acrobotic/Ai_Pulsar_Hardware/pcb/fab/BOM.xls

Ai Pulsar – BOM
Cisco Zabala (x1sc0@acrobotic.com) last updated: 31.07.2015
Manufacturer | Manuf. Part Number | Vendor | Vendor Part Number | SKU | Type | Designator | Qty | Description | Case | SMD, BGA, LCC, OR TH | Notes
Vishay | CRCW060322R0JNEA | Digi-Key | 541-22GTR-ND | RES-00003-022 | Resistors | R1, R2 | 2 | RES 22 OHM 1/10W 5% 0603 | 0603 | SMD
Vishay | CRCW060310K0JNEA | Digi-Key | 541-10KGTR-ND | RES-00003-103 |  | R3, R4 | 2 | RES 10K OHM 1/10W 5% 0603 | 0603 | SMD
Vishay | CRCW0603100RJNEA | Digi-Key | 541-100GTR-ND | RES-00003-110 |  | R5 | 1 | RES 100 OHM 1/10W 5% 0603 | 0603 | SMD
Vishay | CRCW06031K00JNEA | Digi-Key | 541-1.0KGTR-ND | RES-00003-102 |  | R6, R7 | 2 | RES 1K OHM 1/10W 5% 0603 | 0603 | SMD
Vishay | CRCW0603330RJNEA | Digi-Key | 541-330GTR-ND | RES-00003-133 |  | R8, R9 | 2 | RES 330 OHM 1/10W 5% 0603 | 0603 | SMD
Bel Fuse | 0ZCJ0075FF2E | Digi-Key | 507-1804-1-ND | PWR-00013 |  | F1 | 1 | PTC RESTTBLE 0.75A 6V CHIP 1206 | 0603 | SMD
Murata | GRM188R61A106ME69D | Digi-Key | 490-10475-2-ND | CAP-00004-310 | Capacitors | C1, C3 | 2 | CAP CER 10UF 10V 0603 | 0603 | SMD
Samsung | CL10F104ZA8NNNC | Digi-Key | 1276-1011-2-ND | CAP-00004-610 |  | C2, C4, C5, C6…C29 | 27 | CAP CER 0.1UF 25V 0603 | 0603 | SMD
Epson | MC-146 32.768KA-AC3:ROHS | Mouser | 732-MC14632.76KAAC3R | FRQ-00005 | Crystals | XL1 | 1 | CRYSTAL 32.768KHZ 12.5PF SMD (MC-146) | 5mm x 1.5mm | SMD
NXP | PMEG4005CT,215 | Mouser | 771-PMEG4005CT215 | DIO-00008 | Diode | D1 | 1 | SCHOTTKY DIODE 31ACDBZR/SOT (PMEG4005CT) | SOT-23 | SMD
WorldSemi | WS2812B | WorldSemi | WS2812B | LED-00008 | LEDs | LED1…LED24 | 24 | WS8212B RGB LED | 5050 | SMD | ONLY INSTALL IN 35 BOARDS
OSRAM | LY L29K-H1K2-26-Z | Digi-Key | 475-1196-1-ND | LED-00036 |  | LED25, LED26 | 2 | LED YELLOW 587NM 0603 SMD | 0603 | SMD
RF Digital | RFD-22301 | Acrobotic | RFD-22301 | RFD-22301 | ICs | RFDUINO | 1 | RFduino BLE 4.0 SMT Module | - | SMD | DNI
Maxim | DS1307Z+T&R | Digi-Key | DS1307Z+T&RCT-ND | CHP-00037 |  | IC1 | 1 | IC RTC CLK/CALENDAR I2C 8-SOIC (DS1307) | 8-SOIC | SMD
Micrel | MIC5219-3.3YM5 TR | Digi-Key | 576-1281-1-ND | CHP-00027 |  | U1 | 1 | IC REG LDO 3.3V 0.5A SOT23-5 (MIC5219-3.3) | SOT23-5 | SMD
FTDI | FT231XQ-R | Mouser | 895-FT231XQ-R | CHP-00046 |  | U2 | 1 | USB Interface IC USB to Full Serial UART IC QFN-20 (FT231X) |  | SMD
Keystone | 3030TR | Mouser | 534-3030TR | CON-00037 | Connectors | 3V-BATT | 1 | 10MM SM COIN BATTERY HOLDER SMD | - | SMD
JST | S3B-PH-SM4-TB(LF)(SN) | Digi-Key | 455-1750-2-ND | CON-00039 |  | J1 | 1 | JST 3-PIN CCONNECTOR MALE (SMT) | JST-3P-SMD | SMD
JST |  | Digi-Key |  | CON-00038 |  | J2 | 1 | JST 2-PIN CCONNECTOR MALE (SMT) | JST-2P-SMD | SMD | DNI
 |  | Acrobotic | CON-00014 | CON-00014 | Connect. | USB1 | 1 | USB Micro-B Connector (Through Hole) | - | TH | Similar to: http://j.mp/1IuNWtk
