acrobotic/Ai_Pulsar_Hardware/pcb/ai_pulsar.brd

## EAGLE design pcb/ai_pulsar.brd (2016-04-01)

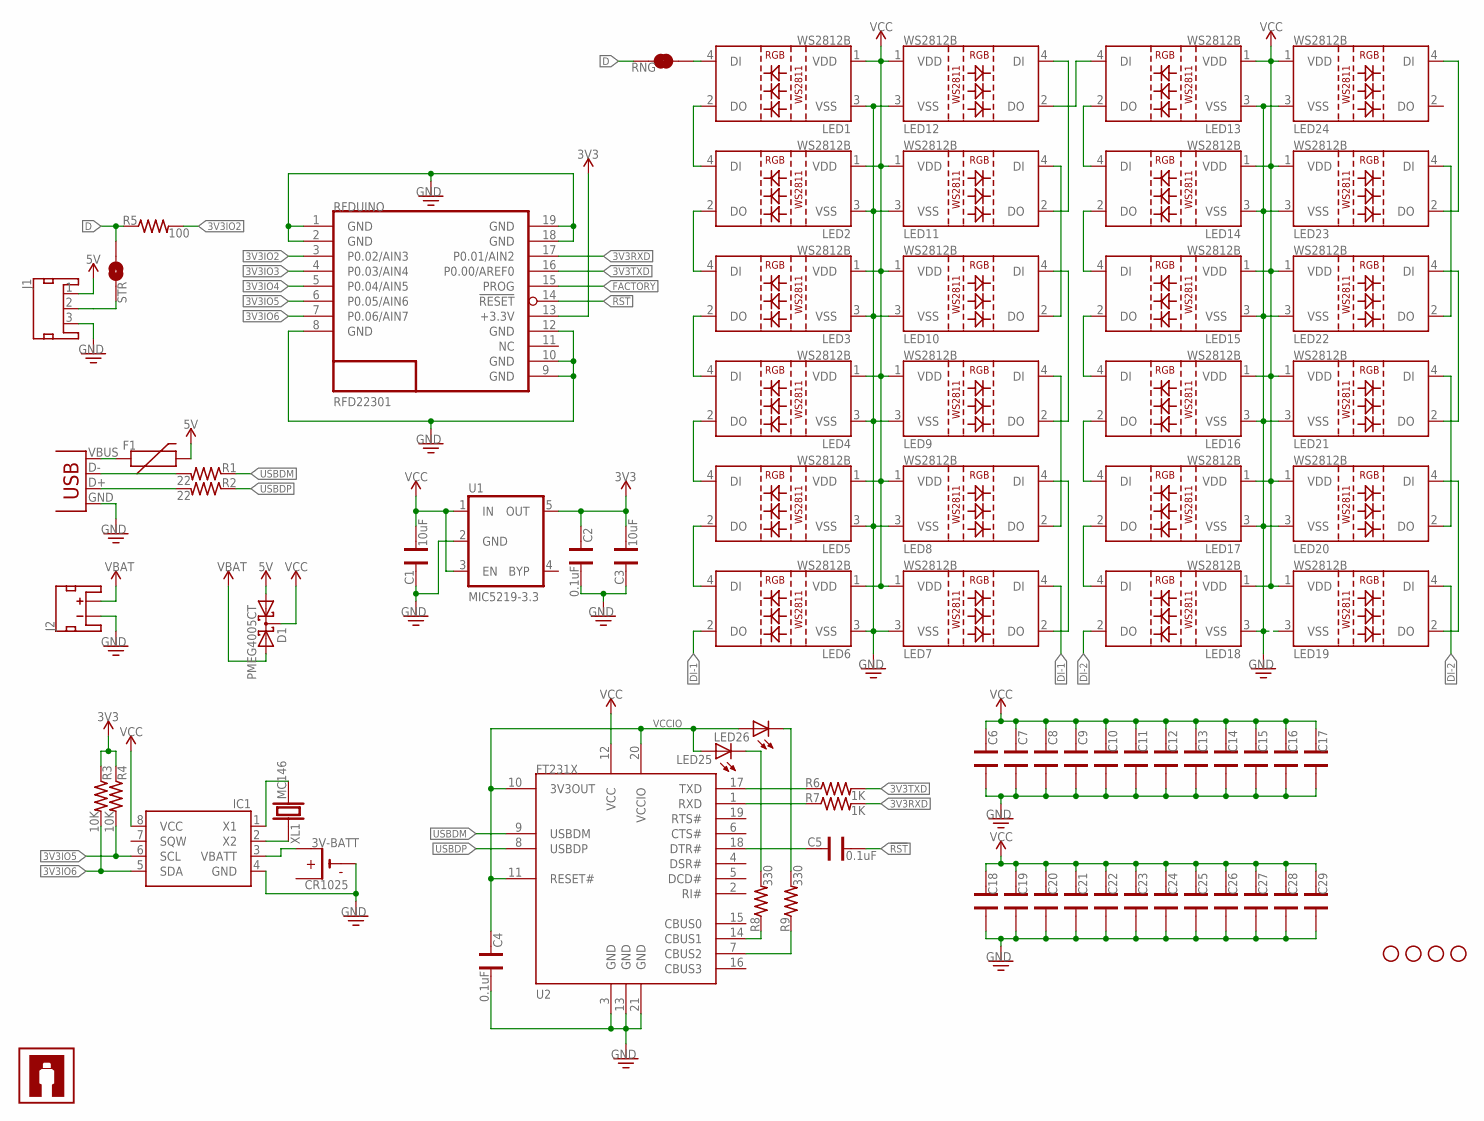
[picture p1: schematic ai_pulsar.sch]

Parts:
3V-BATT: CR1025; CR1025-SMD
C1, C3: 10uF; CAP-0603
C2, C4, C5: 0.1uF; CAP-0603
C6, C7, C8, C9, C10, C11, C12, C13, C14, C15, C16, C17, C18, C19, C20, C21, C22, C23, C24, C25, C26, C27, C28, C29: CAP0603; CAP-0603
D1: PMEG4005CT; SOT-23
F1: PTCSMD; PTC-1206
IC1: DS1307SO8-TIGHT; SO08-TIGHT
J1: JST-3P-MALE; JST-3P-SMD
J2: JST-2P-MALE; JST-2P-SMD
LED1, LED2, LED3, LED4, LED5, LED6, LED7, LED8, LED9, LED10, LED11, LED12, LED13, LED14, LED15, LED16, LED17, LED18, LED19, LED20, LED21, LED22, LED23, LED24: LED-WS2812B-SM
LED25, LED26: LED0603; LED-0603
R1, R2: 22; RES-0603
R3, R4: 10K; RES-0603
R5: 100; RES-0603
R6, R7: 1K; RES-0603
R8, R9: 330; RES-0603
RFDUINO: RFD22301
RNG: 1X02-SJ-NC
STANDOFF1, STANDOFF2, STANDOFF3, STANDOFF4: STAND-OFF4T; STAND-OFF-4T
STR: 1X02-SJ-NO
U1: MIC5219-3.3; SOT23-5
U2: FT231X-Q; QFN20
U$9: AI-LOGOXS; AI-LOGO-XS
USB1: USBMICROB-TH; USB-MICROB-TH
XL1: MC146; EPSON-MC146

Connections:
3V3: C2.2, C3.1, R3.1, R4.1, RFDUINO.13 (+3.3V), U1.5 (OUT)
3V3IO2: R5.2, RFDUINO.3 (P0.02/AIN3)
3V3IO3: RFDUINO.4 (P0.03/AIN4)
3V3IO4: RFDUINO.5 (P0.04/AIN5)
3V3IO5: IC1.6 (SCL), R4.2, RFDUINO.6 (P0.05/AIN6)
3V3IO6: IC1.5 (SDA), R3.2, RFDUINO.7 (P0.06/AIN7)
3V3RXD: R7.2, RFDUINO.17 (P0.01/AIN2)
3V3TXD: R6.2, RFDUINO.16 (P0.00/AREF0)
5V: D1.1 (A1), F1.2, J1.1
!RST: C5.1, RFDUINO.14 (!RESET)
D: J1.2, R5.1, RNG.2, STR.1
DI-1: LED6.2 (DO), LED7.4 (DI)
DI-2: LED18.2 (DO), LED19.4 (DI)
FACTORY: RFDUINO.15 (PROG)
GND: 3V-BATT.-, C1.2, C2.1, C3.2, C4.1, C6.1, C7.1, C8.1, C9.1, C10.1, C11.1, C12.1, C13.1, C14.1, C15.1, C16.1, C17.1, C18.1, C19.1, C20.1, C21.1, C22.1, C23.1, C24.1, C25.1, C26.1, C27.1, C28.1, C29.1, IC1.4 (GND), J1.3, J2.2 (-), LED1.3 (VSS), LED2.3 (VSS), LED3.3 (VSS), LED4.3 (VSS), LED5.3 (VSS), LED6.3 (VSS), LED7.3 (VSS), LED8.3 (VSS), LED9.3 (VSS), LED10.3 (VSS), LED11.3 (VSS), LED12.3 (VSS), LED13.3 (VSS), LED14.3 (VSS), LED15.3 (VSS), LED16.3 (VSS), LED17.3 (VSS), LED18.3 (VSS), LED19.3 (VSS), LED20.3 (VSS), LED21.3 (VSS), LED22.3 (VSS), LED23.3 (VSS), LED24.3 (VSS), RFDUINO.1 (GND), RFDUINO.2 (GND), RFDUINO.8 (GND), RFDUINO.9 (GND), RFDUINO.10 (GND), RFDUINO.12 (GND), RFDUINO.18 (GND), RFDUINO.19 (GND), U1.2 (GND), U2.3 (GND), U2.13 (GND), U2.21 (GND), USB1.GND
unnamed: 3V-BATT.+@1 (+1), 3V-BATT.+@2 (+1), IC1.3 (VBATT)
unnamed: R1.2, USB1.D-
unnamed: IC1.2 (X2), XL1.P$1 (1)
unnamed: IC1.1 (X1), XL1.P$2 (2)
unnamed: F1.1, USB1.VBUS
unnamed: R2.2, USB1.D+
unnamed: R7.1, U2.1 (RXD)
unnamed: R6.1, U2.17 (TXD)
unnamed: C5.2, U2.18 (DTR#)
unnamed: LED26.C, R9.2
unnamed: LED25.C, R8.2
unnamed: LED12.2 (DO), LED13.4 (DI)
unnamed: R8.1, U2.14 (CBUS1)
unnamed: R9.1, U2.7 (CBUS2)
unnamed: LED2.2 (DO), LED3.4 (DI)
unnamed: LED3.2 (DO), LED4.4 (DI)
unnamed: LED4.2 (DO), LED5.4 (DI)
unnamed: LED5.2 (DO), LED6.4 (DI)
unnamed: LED7.2 (DO), LED8.4 (DI)
unnamed: LED8.2 (DO), LED9.4 (DI)
unnamed: LED9.2 (DO), LED10.4 (DI)
unnamed: LED10.2 (DO), LED11.4 (DI)
unnamed: LED11.2 (DO), LED12.4 (DI)
unnamed: LED13.2 (DO), LED14.4 (DI)
unnamed: LED14.2 (DO), LED15.4 (DI)
unnamed: LED15.2 (DO), LED16.4 (DI)
unnamed: LED16.2 (DO), LED17.4 (DI)
unnamed: LED1.4 (DI), RNG.1
unnamed: LED1.2 (DO), LED2.4 (DI)
unnamed: LED17.2 (DO), LED18.4 (DI)
unnamed: LED19.2 (DO), LED20.4 (DI)
unnamed: LED20.2 (DO), LED21.4 (DI)
unnamed: LED21.2 (DO), LED22.4 (DI)
unnamed: LED22.2 (DO), LED23.4 (DI)
unnamed: LED23.2 (DO), LED24.4 (DI)
USBDM: R1.1, U2.9 (USBDM)
USBDP: R2.1, U2.8 (USBDP)
VBAT: D1.2 (A2), J2.1 (+)
VCC: C1.1, C6.2, C7.2, C8.2, C9.2, C10.2, C11.2, C12.2, C13.2, C14.2, C15.2, C16.2, C17.2, C18.2, C19.2, C20.2, C21.2, C22.2, C23.2, C24.2, C25.2, C26.2, C27.2, C28.2, C29.2, D1.3 (CC), IC1.8 (VCC), LED1.1 (VDD), LED2.1 (VDD), LED3.1 (VDD), LED4.1 (VDD), LED5.1 (VDD), LED6.1 (VDD), LED7.1 (VDD), LED8.1 (VDD), LED9.1 (VDD), LED10.1 (VDD), LED11.1 (VDD), LED12.1 (VDD), LED13.1 (VDD), LED14.1 (VDD), LED15.1 (VDD), LED16.1 (VDD), LED17.1 (VDD), LED18.1 (VDD), LED19.1 (VDD), LED20.1 (VDD), LED21.1 (VDD), LED22.1 (VDD), LED23.1 (VDD), LED24.1 (VDD), U1.1 (IN), U1.3 (EN), U2.12 (VCC)
VCCIO: C4.2, LED25.A, LED26.A, U2.10 (3V3OUT), U2.11 (RESET#), U2.20 (VCCIO)

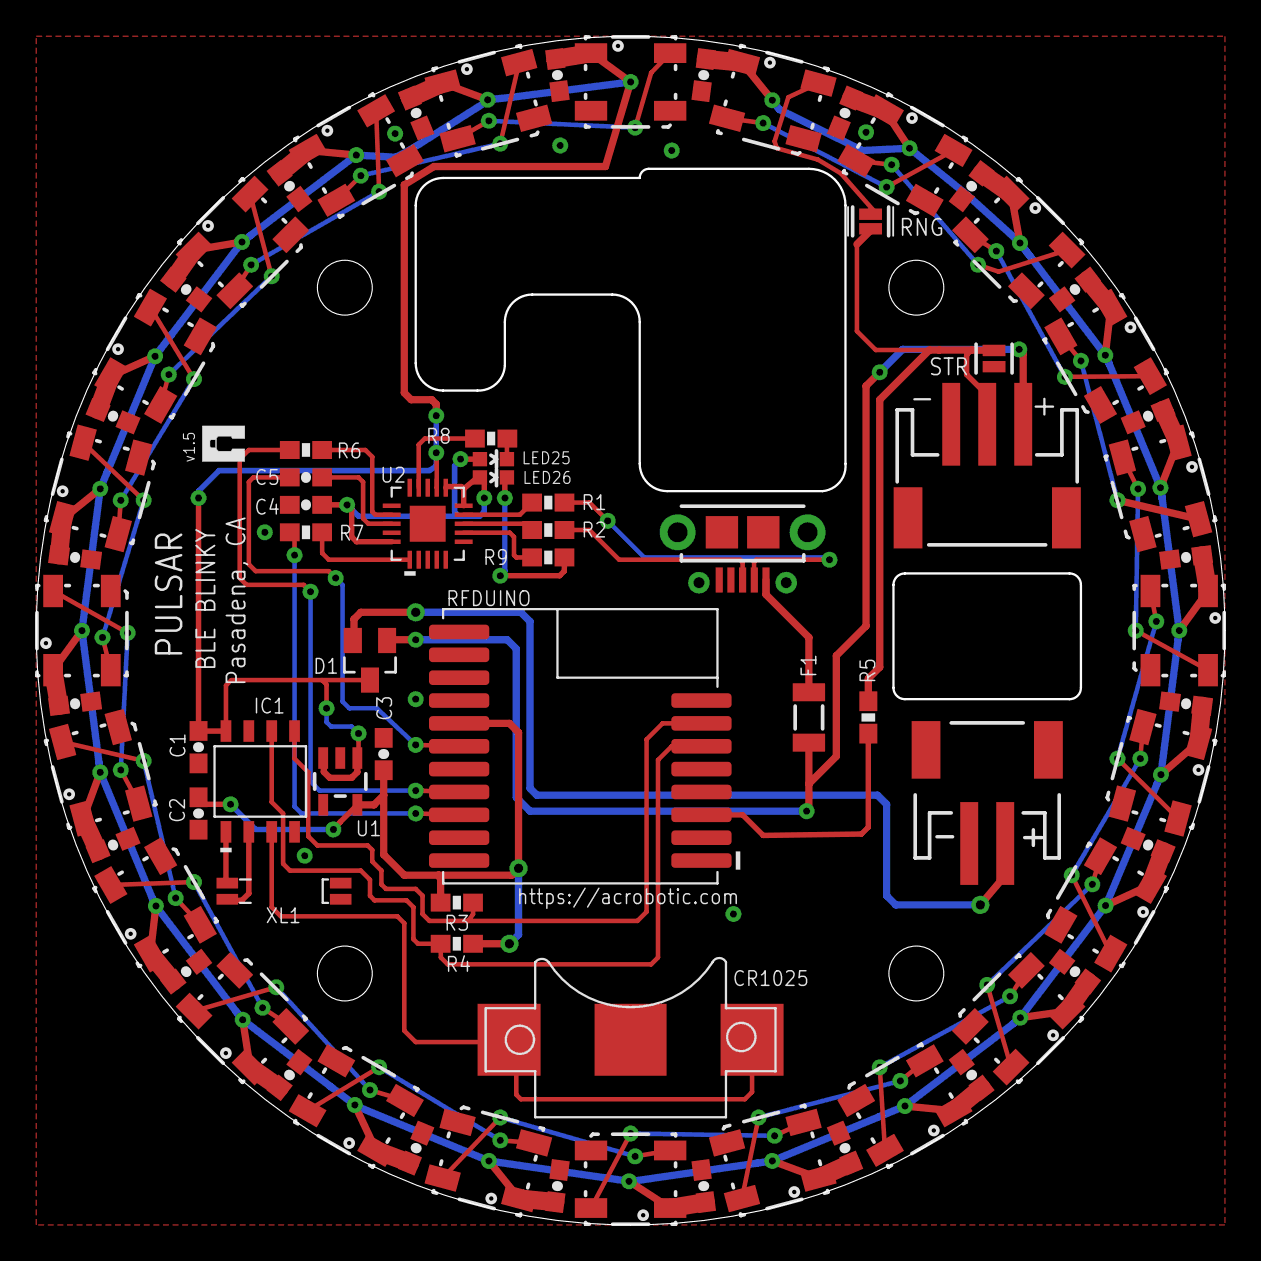
[picture p2: board ai_pulsar.brd from above]

Board: 2 copper layers, 66.0 x 66.0 mm, 82 parts (0 on the bottom side), 52 nets.
