acrobotic/Ai_Pulsar_Hardware/(commit log)

2014-11-26 routing finished
    [ai_pulsar.brd, ai_pulsar.sch]
2014-11-27 generated gerbers
    [ai_pulsar.brd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]
2014-11-27 minor silkscreen changes
    [ai_pulsar.brd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]
2014-12-17 renamed a few parts
    [BOM.xls, ai_pulsar.brd, ai_pulsar.sch]
2014-12-23 version 1.1. Fixed coin-cell polarity, added 5V on FTDI pins for easy programming
    [ai_pulsar.brd, ai_pulsar.sch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]
2014-12-23 added comment on remaining airwire.
    [ai_pulsar.brd]
2014-12-25 minor silkscreen fix
    [ai_pulsar.brd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]
2015-05-29 routing under way
    [ai_pulsar.brd, ai_pulsar.sch]
2015-05-30 routed v1.3
    [ai_pulsar.brd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]
2015-05-31 latest gerbers
    [ai_pulsar.gbl, ai_pulsar.gbs, ai_pulsar.gtl, ai_pulsar.gto, ai_pulsar.gtp, ai_pulsar.gts]
2015-06-29 fiddling with cutouts
    [BOM.xls, ai_pulsar.brd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]
2015-07-20 bigger cutout for micro-B connector
    [ai_pulsar.brd, ai_pulsar.sch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]
